misha-z1nchuk/dronebench-ate/README.md

# DroneBench ATE

Automated test equipment for 1S FPV drones. The bench answers one question —
*is this airframe safe to fly, and if not, what should I check next?* — by
measuring the power path while driving the flight controller through a
standardised test sequence.

**Status: in development.** Nothing here is validated against hardware yet.

- [Plan and schematics](dronebench_ate_final_plan.md) (Ukrainian)
- [Progress log](PROGRESS.md) (Ukrainian)

## What it does

Measures battery voltage and current draw through a custom analog front-end,
cross-checked against an independent I2C reference so the bench can state its
own measurement uncertainty rather than assume it. Runs each motor separately
with props removed, compares current profiles, and classifies the result:

```
PASS · REPAIR_MINOR · REPAIR_ELECTRONICS · UNSAFE · UNKNOWN
```

Reports name what was observed, what could cause it, and which test isolates
it — never that a specific part has failed, unless an isolation test proved it.

## Layout

```
firmware/core/       portable logic — no vendor SDK headers, ever
firmware/platform/   host / esp32 / stm32 implementations of platform.h
firmware/app/        wiring for the target build
firmware/tests/      host unit tests for the core
tools/               Python: serial logger, report generator, simulator
test_profiles/       per-airframe limits
docs/                measurement methodology, error budget
```

The core compiles and passes its tests on a desktop compiler with no board
attached. That constraint is what keeps it portable between ESP32 and STM32.

## Build

Host tests, no hardware needed:

```sh
make test
```

Firmware (ESP-IDF v5.5, target ESP32):

```sh
. ~/esp/esp-idf/export.sh
idf.py -C firmware/app/esp32 build flash monitor
```

On macOS and Linux, `install.sh` deliberately does not install CMake and Ninja
— it expects them from the system package manager. If `idf.py` reports
`"cmake" must be available on the PATH`, pull them into the IDF toolchain
instead of installing them system-wide:

```sh
python3 $IDF_PATH/tools/idf_tools.py install cmake ninja
```

## Editor

VS Code with the **clangd** extension. The Microsoft C/C++ extension is
disabled for this workspace in `.vscode/settings.json` — it tries to index the
whole ESP-IDF tree up front and stalls; clangd reads `compile_commands.json`
and indexes lazily.

Two config files make it work: `.clangd` strips four GCC-only flags that clangd
rejects outright, and `compile_flags.txt` covers the portable core, which no
`compile_commands.json` describes. Run `make fw` once before opening the ESP32
sources — the compilation database is generated by the build.

## Hardware

| | |
|---|---|
| MCU | ESP32-WROOM-32 → STM32 NUCLEO-F446RE |
| Current, analog | ACS724 + ADC1, ratiometric VCC correction |
| Current, reference | INA226 + 10 mΩ shunt over I2C |
| Voltage | 10k/10k divider, RC filtered |
| Device under test | BetaFPV Meteor75 Pro, 1S |

Pin map and schematics: [plan §4](dronebench_ate_final_plan.md).

## Safety

Motor current never passes through a breadboard or Dupont wiring. Props are
removed for every test. The full checklist is in the plan — read it before
connecting a battery.
