misha-z1nchuk/dronebench-ate/PROGRESS.md

# DroneBench ATE — журнал прогресу

Робочий трекер. План і схемотехніка — у [dronebench_ate_final_plan.md](dronebench_ate_final_plan.md).

---

## Статус

| | |
|---|---|
| **Поточна фаза** | Фаза 1 — Software |
| **Поточний день** | Фаза 1 завершена. Далі Фаза 1b (MSP spike) або День 11 — монтаж |
| **Дата старту** | 2026-08-05 |
| **Блокери** | немає. Одноразовий `power-on` ресет 22:28 не повторився на повному 10-хвилинному прогоні |
| **Наступний блокер** | немає — усе залізо на місці, Фаза 2 відкрита після Дня 10 |
| **Формат роботи** | див. [Розподіл роботи](#розподіл-роботи) |

**Зараз у роботі:** Дні 1–10 закриті, **Фаза 1 завершена**. Milestone 1 виконаний окрім README в корені. Далі на вибір: Фаза 1b (MSP spike — потрібні лише дрон, батарея і USB) або День 11 (монтаж аналогового тракту). Фазу 1b варто зробити не пізніше Дня 16.

**Легенда:** ⬜ не почато · 🟡 в роботі · ✅ готово · ⏸ відкладено

---

## Як користуватись

1. Починаючи день — міняєш ⬜ на 🟡 у заголовку.
2. Закриваючи — ✅ і ставиш дату.
3. Усі виміряні числа йдуть у [Журнал вимірювань](#журнал-вимірювань), а не в голову.
4. Кожне рішення «купувати / не купувати / робити інакше» — у [Журнал рішень](#журнал-рішень) з причиною.
5. Теорія на день — 30–60 хвилин. Критерій засвоєння: можеш відповісти на питання в кінці блоку **своїми словами, без гуглення**.

---

## Постачання

**Усе на місці.** Вхідний контроль пройдено 2026-08-12, результати в [Журналі вимірювань](#журнал-вимірювань).

### Є
- [x] ESP32-WROOM-32, Meteor75 Pro, батареї **1S LiHV** (4.35 V), MB102
- [x] ACS724 50A — **виконання AB**, підтверджено вимірюванням
- [x] BT2.0 extension ×2, провід 18AWG, резистори 1 Ω 50 W ×2
- [x] Резистори 10 kΩ і 20 kΩ, конденсатори 100 nF, Dupont, термоусадка
- [x] Logic analyzer 8ch/24MHz
- [x] NUCLEO-F446RE
- [x] **Мультиметр** VIRONE dm-1 — після заміни крони справний

### Лишилось перевірити — некритичне, нічого не блокує
- [ ] Розкид 5 резисторів із пачки 10 kΩ — єдине, що цей прилад міряє достовірно
- [ ] Груба перевірка 1 Ω (має показати 1.2–1.8 разом зі щупами, не 10)
- [ ] Logic analyzer + PulseView, зловити UART від ESP32
- [ ] NUCLEO: том `NODE_F446RE` — **чекає кабель Type-C → Mini-USB**

### Рішення відкладені
- [ ] INA226 з шунтом **0.01 Ω** — купувати чи ні, вирішується після Дня 13 за критерієм 3.3.1 плану
- [ ] Тримач автозапобіжника + ножові 15/20 A — безпека, до Дня 15

### Перевірити вдома
- [ ] Паяльник 60 W+, припій, флюс
- [ ] Металева пластина / радіатор під резистори 1 Ω

---

# ФАЗА 1 — Software (Дні 1–10)

Не потребує жодного заліза, крім самої ESP32.

---

### ✅ День 1 — ESP-IDF і repository — 2026-08-06

**Мета:** ESP32 стабільно збирається, шиється і щось каже в UART.

- [x] Встановити ESP-IDF v5.5 + тулчейн для esp32 → `~/esp/esp-idf`
- [x] `.gitignore`, README-заготовка
- [x] Створити структуру каталогів за розділом 6 плану
- [x] Host-збірка і test runner (`make test`)
- [x] Записати модель плати і заповнити pin map (розділ 4.5 плану)
- [x] Каркас застосунку `firmware/app/esp32`, збірка проходить (181 KB)
- [x] Прошито на плату, банер і heartbeat працюють — 2026-08-05
- [x] Розмір флеш підтверджено `esptool flash_id` → 4 MB, виставлено в `sdkconfig.defaults`
- [x] Банер: chip model, revision, cores, features, free heap, reset reason
- [x] Перший commit `de00dff`, запушено на github.com/misha-z1nchuk/dronebench-ate

**Активація середовища у новому терміналі:** `. ~/esp/esp-idf/export.sh`

**Пастка, на яку натрапили:** `install.sh` на macOS навмисно не ставить `cmake` і `ninja` — очікує їх від системного пакетного менеджера. `idf.py` падає з `"cmake" must be available on the PATH`. Витягли їх у тулчейн IDF, не в систему:

```sh
python3 $IDF_PATH/tools/idf_tools.py install cmake ninja
```

Ще одна: `. export.sh` не можна запускати через pipe (`. export.sh | tail`) — pipe створює підоболонку, і змінні середовища не долітають до поточного шелу.

**Done коли:** `idf.py flash monitor` показує банер із версією і причиною ресету; після `Ctrl+T Ctrl+R` причина ресету змінюється.

**Теорія:**
- Що таке toolchain і навіщо cross-compilation. Чим `xtensa-esp32-elf-gcc` відрізняється від системного `gcc`.
- Boot flow ESP32: ROM bootloader → second-stage bootloader → app. Де живе кожен.
- Partition table: що таке `factory`, `nvs`, `phy_init`.
- Reset reasons: power-on, brownout, watchdog, panic. Чому це перше, що треба логувати.

> **Питання:** що відбувається між подачею живлення і викликом `app_main()`?

---

### ✅ День 2 — UART CLI — 2026-08-06

**Мета:** з платою можна розмовляти текстом.

**Ядро — готове, 19 тестів, `make test` = PASS**

- [x] Line buffer з фіксованим розміром, без динамічної пам'яті
- [x] Обробка `\r`, `\n`, `\r\n`, backspace, DEL, недрукованих
- [x] Overflow: рядок довший за буфер не ламає парсер і дає зрозумілу помилку
- [x] Таблиця команд замість ланцюжка `if/else`
- [x] Токенізація на місці, без копіювання
- [x] Реакція на невідому команду, порожній рядок і надлишок аргументів
- [x] Жодного `strcpy`, `strcat`, `sprintf`, `gets`, `malloc`

**Підключення до заліза — готове**

- [x] `cli_uart.c` — драйвер UART0, таска-читач, вихідний адаптер
- [x] Таблиця команд у застосунку: `help`, `version`, `status`
- [x] Перевірено в `idf.py monitor`: команди, помилки, backspace, відновлення після переповнення

**Знайдено під час роботи:**

- Тест не ловив, що після відхиленого рядка буфер не скидався. Наслідок був не «помилка», а **виконання попередньої команди замість нової** — стенд мовчки робив не те, що просили. Додано регресійний тест.
- `tokenize_line` мовчки обрізав до `CLI_ARGS_MAX` замість повідомити про переповнення. Той самий клас проблеми, що й тиха втрата вибірок телеметрії.

**Done коли:** можна вставити в термінал 500 символів сміття — CLI відповідає помилкою і далі працює нормально.

**Теорія:**
- UART: baud rate, старт/стоп-біти, парність, framing error. Чому 115200.
- Ring buffer: навіщо і як реалізується без блокувань.
- Чому `strcpy`/`sprintf` заборонені в embedded і що замість них (`strncpy` теж має пастку — яку?).
- Stack vs heap у мікроконтролері. Чому `malloc` уникають.

> **Питання:** чим `snprintf` безпечніший за `sprintf` і що він повертає, якщо буфер замалий?

---

### ✅ День 3 — Portable core — 2026-08-07

**Мета:** ядро компілюється і тестується на Mac без жодного ESP-IDF.

- [x] `platform.h` — інтерфейс за розділом 6 плану
- [x] Ядро не містить жодного `#include "esp_*"`
- [x] Host-збірка, `make test` — 27 випадків, 82 перевірки
- [x] `check-core` — вартовий межі, падає при вендорному заголовку в `firmware/core/`
- [x] Host-платформа: керований час, підставні покази, захоплений вивід
- [x] ESP32-платформа: час, UART, LED, watchdog. ADC — чесні відмови до Дня 12
- [x] Консольний порт переїхав із `cli_uart.c` у платформу — прихованої залежності за порядком більше немає
- [x] Перевірено на залізі: uptime росте, купа стабільна між викликами

**Знайдено під час роботи:**

- `platform_watchdog_feed` реалізована, але **нічого не годує**: жодна таска не підписана на TWDT, тому `esp_task_wdt_reset()` завжди повертає `ESP_ERR_NOT_FOUND`. Зафіксовано коментарем у коді. **Перевірити на Дні 10.**
- Забутий `#include` дав помилку формату в іншому місці й іншого змісту: без оголошення C припускає, що функція повертає `int`. Перша помилка в списку компілятора майже завжди справжня, решта — наслідки.
- clangd не знаходить базу збірки для файлів поза деревом проєкту ESP-IDF. Розв'язано локальним `.clangd` у `firmware/platform/esp32/`. Той самий трюк знадобиться для STM32.

**Done коли:** `make test` працює на Mac, і в `firmware/core/` немає жодної згадки про ESP-IDF.

**Теорія:**
- Що таке HAL і навіщо шар абстракції. Ціна абстракції.
- Dependency injection у C: вказівники на функції, структури-втабліці.
- Compilation vs linking. Що таке translation unit, `static`, `extern`.
- Чому юніт-тести в embedded зазвичай запускають на хості, а не на залізі.

> **Питання:** як протестувати код, що читає час, не чекаючи реального часу?

---

### ✅ День 4 — Семплер і валідація — 2026-08-21

**Мета:** ядро вміє «вимірювати» без сенсорів і не вірить зіпсованим даним.

- [x] Fake measurement provider за `platform.h` — зроблено на Дні 3
- [x] Монотонні мітки часу `uint64_t`, відхилення немонотонних
- [x] Fault injection: відмова каналу, NaN, Inf, немонотонний час, розриви
- [x] Кожна відмова має власний лічильник — кількість невзятих вибірок є частиною результату
- [x] Опційний референсний канал деградує до `NAN`, а не валить сесію
- [x] 13 тестових випадків, `make test` — 40 випадків / 148 перевірок PASS

**Відкладено, і чому:** профілі `normal` / `motor4_fail` / `sag` / `short` — це генератор реалістичних форм сигналу, і йому поки нема куди подавати дані. Робиться разом із Днем 6 (машина станів), потрібен до Дня 9.

**Хто писав:** `sampler_take` і `sampler_had_trouble` — Claude, після того як я застряг. Решта дня моя. Див. [Розподіл роботи](#розподіл-роботи).

**Ключові рішення в коді:**

- `*out` заповнюється **тільки** при `SAMPLE_OK` — викликач, що отримав відмову, тримає рівно те, що мав до виклику
- Відхилена вибірка **не оновлює** `last_timestamp_us` — інакше один збій перевів би годинник сесії назад і поклав усі наступні
- `isfinite()`, а не перевірка на `NAN` — нескінченність з'являється від ділення на нульовий коефіцієнт калібрування і проходить будь-яку перевірку діапазону
- Порівняння часу через `<=`, не `<` — дві вибірки з однаковою міткою це збій, а не «дуже швидко»

**Done коли:** зіпсовані вибірки відхиляються з лічильником, а не ламають розрахунки. ✅

**Теорія:**
- Чому мітки часу монотонні і чому `uint64_t`. Коли переповниться `uint32_t` у мікросекундах?
- Timer wraparound і правильне віднімання міток часу.
- Float у мікроконтролері: чи є FPU в ESP32 і в STM32F446, ціна `double`.
- NaN, Inf, `isfinite()`. Що станеться з середнім, якщо в вибірці один NaN.

> **Питання:** чому `if (now - last > timeout)` безпечніше за `if (now > last + timeout)`?

---

### ✅ День 5 — Розрахунки метрик — 2026-08-21

**Мета:** з потоку вибірок виходять коректні метрики.

- [x] Потужність, min/max напруги, піковий струм
- [x] Спожиті mAh через інтегрування по часу
- [x] Спожиті Wh
- [x] Середній струм, тривалість сесії
- [x] 9 тестових випадків, `make test` — 49 випадків / 173 перевірки PASS

**Хто писав:** Claude, за розподілом — арифметика не embedded. Ключове рішення про ширину акумулятора розібране нижче.

**Головне з дня — чому акумулятори `double`, а результати `float`**

Годинна сесія на 500 Hz — це 1.8 млн додавань. У `float` це втрачає **+1.5%** на бездоганних вхідних даних:

```
правильно  1000.00 mAh
double     1000.00 mAh   ±0.0000%
float      1014.99 mAh   +1.4994%
```

Причина: точність `float` **відносна**. Коли акумулятор доріс до 3.6e9, крок між сусідніми представними значеннями — 429, а доданок 2000 це лише ~4.6 кроки. Кожне додавання округлюється, округлення зміщені в один бік, і похибка росте **лінійно** з кількістю вибірок.

Тест `charge accumulates across a long session without drifting` перевірений підміною типу — з `float` падає. Тобто це не коментар, а виконуваний захист.

**Embedded-нюанс:** ні Xtensa LX6 в ESP32, ні Cortex-M4F у STM32F446 **не мають FPU подвійної точності**. Уся арифметика `double` — програмна емуляція. Тут це прийнятно: 500 операцій на секунду проти 240 МГц. Але саме тому результати назовні лишаються `float` — вони віддаються один раз, а акумулятори працюють на кожній вибірці.

**Друга пастка — приведення типу в множенні**

```c
acc += sample->current_a * dt_us;          // ❌ множення у float
acc += (double)sample->current_a * dt_us;  // ✅ множення в double
```

Без приведення добуток обчислюється у `float` і лише готовий результат розширюється при додаванні. Тобто акумулятор широкий, а годують його вже округленими числами.

**Знайдено в інфраструктурі:** Makefile не відстежував заголовки. Зміна `.h` не викликала перезбірку, і тест показував `PASS` там, де мав падати. Виправлено через `-MMD -MP` + `-include`. Найгірший клас проблем зі збіркою — та, що не помиляється, а **бреше про успіх**.

**Done коли:** тести на відомих сигналах сходяться з аналітичним результатом. ✅

**Теорія:**
- Чисельне інтегрування: метод прямокутників vs трапецій. Похибка кожного.
- Накопичення похибки при додаванні мільйонів `float`. Чому акумулятор краще тримати в `double`.
- A·µs → mAh: звідки береться 3.6e6.
- Що робити з розривом у потоці вибірок — інтегрувати чи ні.

> **Питання:** чому сума 10 000 однакових `float` не дорівнює `значення × 10000`?

---

### ✅ День 6 — Машина станів сесії — 2026-08-21

**Мета:** сесія тесту має чіткі стани й дозволені переходи.

- [x] Фази `IDLE → PRECHECK → RUNNING → DONE`
- [x] Знахідки `warned` / `failed` / `unsafe` — фіксуються, не скидаються
- [x] Заборонений перехід відхиляється й рахується, а не виконується мовчки
- [x] `session_state_name()` видає лексику плану: IDLE / PRECHECK / RUNNING / WARNING / FAILED / UNSAFE / COMPLETE
- [x] 19 тестових випадків, `make test` — 68 випадків / 255 перевірок PASS

**Дизайн мій, реалізація спільна.**

**Ключове рішення — фази й знахідки окремо**

Початковий список у плані змішував дві незалежні осі:

```
IDLE  PRECHECK  RUNNING  COMPLETE     ← де я в послідовності
WARNING  FAILED                        ← що я знайшов
```

Плоска машина з семи станів дала б **15 переходів**, де `WARNING` дублює майже всі переходи `RUNNING`. І головне — шлях `RUNNING → WARNING → COMPLETE` завершується у `COMPLETE`, і **попередження зникає**: стан його не пам'ятає. Тобто прапорець `had_warning` довелося б завести все одно.

Розділення дає **5 переходів** плюс три незалежні прапорці. Лексика плану лишається як похідне значення — оператор думає станами, код працює фазами.

**Рішення, зашиті в контракт**

| Питання | Відповідь | Чому |
|---|---|---|
| `WARNING → RUNNING`? | ні, фіксується | мета сесії — вердикт, а не поточний стан. Аномалія на 200 мс — це знахідка |
| `stop` під час тесту | завершує з частковими даними, `STOP_OPERATOR` | викидати зібране гірше, ніж чесно позначити неповним |
| `FAILED` vs `UNSAFE` | різні стани | різна дія оператора: від'єднати як завжди vs **негайно висмикнути батарею** |
| Хто завершує сесію | тестова послідовність | плюс тайм-аут → `UNSAFE`, бо незавершений тест це щось не так |
| `start` після `FAILED` | дозволено одразу | `UNSAFE` вимагає явного `reset` |

**Що було не так у першій реалізації**

- `return false` після успішного виконання — у чотирьох функціях. Стан змінився, викликач думає, що ні
- Не перевірялись передумови — шість функцій робили своє, не питаючи, чи можна
- `raise_failure` і `raise_unsafe` ставили прапорець, але не завершували сесію
- `reset` через `session_init` стирав `rejected_requests` — а цей лічильник належить стенду, не сесії, і фіксує розбіжність між оператором і прошивкою

Головне: **написано, що функція робить, і не написано, коли їй не можна.** Сенс машини станів не у виконанні переходів, а у **невиконанні заборонених**.

**Done коли:** тест перебирає всі пари станів і жоден недозволений перехід не проходить. ✅

**Теорія:**
- FSM у C: `switch` vs таблиця переходів. Коли що.
- Інваріанти стану: що має бути істинним у кожному стані.
- Реентерабельність: що буде, якщо `stop` прилетить під час обробки вибірки.

> **Питання:** чим машина станів краща за набір булевих прапорців?

---

### ✅ День 7 — Телеметрія — 2026-08-24

**Мета:** формат даних, який переживе зміну версії й зіпсований канал.

**`make test` = 101 випадок / 467 перевірок PASS. Прошивка збирається без попереджень.**

- [x] Заголовок `TLM,v=2,rate_hz=500,fields=t_us|v|i|i_ref` — версія в першому ж полі
- [x] `S,1000000,4.083,0.420,nan` — 28 байт, позиційний
- [x] `U,n=...,mah=...,sensor=...,rej_time=...,rej_val=...,gaps=...,drop=...` — іменований, порядок не має значення
- [x] Кодувальник **відмовляється** видати обрізаний рядок замість того, щоб віддати неповний
- [x] Парсер відхиляє будь-що до заголовка і будь-яку невідому версію
- [x] Round-trip тести: число → рядок → те саме число
- [x] Лічильники `lines_parsed` / `lines_rejected`

**Хто писав:** Claude — рядкова обробка, не embedded.

**Рішення про пропускну здатність**

```
формат                      байт    @115200    @460800
-------------------------------------------------------
SAMPLE з назвами полів        80       144/с      576/с
S — лише сирі значення        28       411/с     1645/с

потрібно                                          500/с
```

Обрано **обидві зміни**: підвищений baud і короткий рядок. Самого лише скорочення замало — 411 проти 500 не вистачає взагалі, а **консоль ділить той самий UART**.

**Не 921600, а 460800.** На 921600 вивід — суцільне сміття. Місток на цій платі виявився **CH340 (1a86:7523)**, а не CP2102, як припускав план; стелю задає драйвер, а не даташит чіпа. Ідентифіковано через `ioreg -p IOUSB -w0 -l`. На 460800 лишається 1645 рядків/с проти потрібних 500.

**Чому похідні величини все одно передаються**

`power_w` і `used_mah` хост може порахувати сам — але лише з тих вибірок, що долетіли. Прошивка бачить усі. При втратах у каналі хостовий інтеграл занизиться, прошивковий лишиться правильним.

Тому вони йдуть у `U` раз на секунду, з боку прошивки. Розбіжність між двома інтегралами = ціна втрачених вибірок у mAh. Той самий принцип, що в §10.1: два незалежні шляхи до одного числа, різниця між ними — міра довіри.

**Половина тестів — про зіпсовані дані.** Навмисно: щасливий шлях виконується щосекунди роботи, а зламані — рівно тоді, коли вже щось пішло не так.

- `S,1000,4.0` — обрив посеред числа, саме так виглядає переповнення UART. `4.0` при цьому цілком валідне
- порожні рядки — не помилка, інакше лічильник помилок стає безглуздим
- `strtof` перевіряється **за позицією зупинки**, не за повернутим значенням: `strtof("banana")` дає `0.0`, і від справжнього нуля це не відрізнити

**Підключення до заліза — зроблено:**

- [x] UART **460800** через `sdkconfig.defaults`
- [x] `idf.py monitor` тримає швидкість (успадковує `ESP_CONSOLE_UART_BAUDRATE`)
- [x] Таска телеметрії: `sampler_take` → `metrics_add` → `telemetry_encode_sample` → `platform_uart_write`
- [x] `U` раз на секунду
- [x] Лічильник `drop` — періоди, які не встигли
- [x] Команди `start` / `stop` через машину станів Дня 6
- [x] `status` показує стан сесії, одним записом у порт

**Перевірка проти аналітичної моделі.** Числа з плати звірені не «на око», а порахованим інтегралом із констант симулятора:

| | плата | розрахунок |
|---|---|---|
| `imax` | 1.980 | `IDLE_A + MOTOR_A` = 0.38 + 1.60 |
| `vmin` | 4.081 | `4.20 − 1.98 × 0.060` |
| `mah` @ n=1000 | 0.621 | 2.236 А·с / 3.6 |
| `wh` @ n=1000 | 0.0025 | 9.169 Вт·с / 3600 |

Збіг тримається до четвертого знака **тільки якщо рахувати 999 інтервалів, а не 1000** — тобто дані підтверджують і правило «перша вибірка заряду не додає» (`metrics.h:11–13`). При 1000 вийшло б 0.6222, і розбіжність 0.2% легко списалася б на округлення.

**Три пастки, кожна з яких мовчала б:**

1. `pdMS_TO_TICKS(2)` при тіку 100 Гц = **0** — цілочисельне ділення. `xTaskDelayUntil` це відхилив і плата пішла в цикл перезавантажень. Виправлено `CONFIG_FREERTOS_HZ=1000` **плюс `_Static_assert`**, який ловить це на компіляції. Перевірено підстановкою: `SAMPLE_RATE_HZ 2000` → збірка падає.
2. `cmd_status` робив **п'ять** `cli_write` підряд. `uart_write_bytes` атомарний у межах одного виклику, тож під час сесії у відповідь вклинювався рядок вибірки. Переписано на один `snprintf` + один запис.
3. Заголовок `TLM,v=1` у логі виказав, що прошивка не оновилась — рівно та причина, для якої версія стоїть першим полем.

**Теорія:**
- Дизайн протоколу: текстовий vs бінарний, коли який.
- Версіонування. Чому версія має бути в першому ж полі.
- Framing: як приймач розуміє, де початок повідомлення.
- CRC: навіщо, чим відрізняється від checksum.

> **Питання:** що станеться з парсером, якщо UART загубить один байт посеред рядка, і як зробити, щоб він відновився?

---

### ✅ День 8 — Python logger — 2026-08-24

**Мета:** дані з плати лягають на диск без втрат.

- [x] pyserial — через `make venv` (macOS має PEP 668 і забороняє системний `pip install`)
- [x] Читання порту, коректна робота з частковими рядками
- [x] Перевірка версії протоколу з заголовка
- [x] Автоперепідключення при відвалі USB
- [x] Запис CSV у каталог сесії з міткою часу
- [x] Лог помилок парсингу окремо, з номером рядка
- [x] `--simulate` / `--start` / `--for` — логер сам веде сесію
- [x] **Фізична перевірка** — USB висмикнуто посеред сесії

`tools/serial_logger/`: `protocol.py` (формат, без залежностей), `logger.py`, `test_protocol.py` — 31 тест, `make pytest`. Guard-и перевірені підстановкою: без `isfinite` падає 2 тести, зі зламаним збирачем рядків — 4.

**Наскрізна перевірка проти моделі.** 8-секундний прогін `simulate normal`, 4027 вибірок, 8 підсумків, 0 помилок. Кожен рядок `summaries.csv` звірений із чисельним інтегралом по константах симулятора:

| n | mah плата | mah модель |
|---|---|---|
| 500 | 0.105 | 0.1053 |
| 1000 | 0.622 | 0.6216 |
| 2000 | 1.466 | 1.4656 |
| 4000 | 3.410 | 3.4096 |

Розбіжність у всіх восьми точках дорівнює **рівно** різниці між моделлю та моделлю, округленою до трьох знаків. Тобто число на платі — це модель із точністю float, а вся дельта є форматом дроту.

Усі **4026** інтервалів між вибірками — рівно 2000 мкс. Частота 500.00 Гц. Джитер, записаний у борги Дня 10, на симуляції не проявляється; справжня перевірка — під навантаженням Фази 2.

**Спростована гіпотеза:** я вирішив, що відкриття порту скидає плату через DTR/RTS, і записав це в код як факт. Перша мітка часу показала 791 с аптайму — плата пережила відкриття. Причина порожнього першого логу була простіша: сесія не була запущена. Коментар виправлено; затримка на завантаження лишена, бо на іншій платі скид цілком можливий.

**Перевірка розриву — зроблена, не змодельована.** Кабель висмикнуто на 15-й секунді запису:

- `stream_001` містить **усі 7349 вибірок** до моменту розриву, 14.696 с
- `errors.log` **порожній** — обірваний хвіст збирач не віддав, бо тримає рядок до `\n`
- логер перепідключався раз на секунду, поки вузла `/dev/cu.*` не існувало, і після повернення **сам переслав `simulate` і `start`** — цей блок стоїть усередині циклу перепідключення
- `stream_002` почався з `t_us = 2844341` проти `1033664334` у першому. Висмикування знімає живлення, плата перезавантажується, її годинник іде з нуля. В одному файлі це був би стрибок мітки часу **назад на 17 хвилин**, а віднімання двох міток у беззнаковій арифметиці перетворило б від'ємний інтервал на величезний додатний. Розбиття по заголовку саме для цього

**Джитер на довшій вибірці.** 14.7 с дали `{2000: 6762, 2002: 293, 1998: 293}` — ±2 мкс на 8% інтервалів, рівно порівну в обидва боки, тобто биття фази між тіком FreeRTOS і `esp_timer`, не дрейф. Середнє точно 2000. У 8-секундному прогоні цього не було видно взагалі.

**Done коли:** ✅ висмикування USB посеред сесії не втрачає вже записані дані і логер сам відновлюється.

**Теорія:**
- Serial port на хості: буферизація, `timeout`, чому читання по рядках небезпечне.
- Чим `flush()` відрізняється від `fsync()`.
- CSV як формат: коли ламається, навіщо quoting.

> **Питання:** чому не можна просто робити `readline()` і вважати, що прийшов цілий рядок?

---

### ✅ День 9 — Графіки і звіт — 2026-08-24

**Мета:** з CSV виходить читабельний звіт.

- [x] Графіки voltage / current / power по часу, спільна вісь часу
- [x] Summary: min V, max I (p99), avg I, mAh, Wh, тривалість
- [x] Pass/Fail за профілем із розділу 10 плану
- [x] Звіт у форматі розділу 11 плану
- [x] Прогін на `motor4_fail` → звіт називає проблему
- [x] Позначка на графіку, де саме спрацювало правило

`tools/report_generator/`: `analysis.py` (правила, лише стандартна бібліотека), `report.py`, `plots.py`, `generate.py`. 31 тест. Пороги — у `test_profiles/meteor75pro.toml`, не в коді.

**Чотири вердикти, і INCONCLUSIVE вище за PASS.** Прогін, який не вдалося оцінити, — це не прогін, що пройшов. Повертається коли: поріг у профілі досі `tbd`; прошивка не прийняла жодної вибірки (тоді всі числа нулі, бо нічого не міряли, а не бо нічого не було); відповів лише один струмовий канал, тож §10.1 не обчислити.

**Звіт читає `errors.log` логера.** Лінія, яка побила частину рядків до невпізнання, побила й інші — у значення, які **досі парсяться**: втрачена крапка перетворює `4.081` на `4081`. Такі рядки вже лежать у CSV у вигляді вимірювань. Без цієї перевірки звіт звинуватив калібрування ADC у тому, що насправді зробив розхитаний USB-роз'єм.

**Три статистичні рішення, кожне з тестом:**

| вибір | чому |
|---|---|
| медіана, не середнє | дев'ять побитих семплів із тисячі зсувають середнє на 46% і засуджують справний мотор. Медіану не зсувають. Є тест, який падає при підміні на середнє |
| p99, не `max` | максимум — це один семпл, тож його визначає один збій ADC. І він може лише зростати, тобто метрика тим гірша, чим довший тест |
| рахувати сегменти, не лише міряти | мотор, що бере забагато, заявляє про себе сам. Мотор, що не бере нічого, виглядає як тиха ділянка запису |

Місце відсутнього мотора виводиться з ритму тих, що працювали, і малюється на графіку **як очікуване, не як виміряне** — інакше на графіку з'явився б вимір, якого ніхто не робив.

**`data/baselines/motor4_fail/`** — синтетичний запис із наперед відомим дефектом. Фікстура з відомою правильною відповіддю, для якої не потрібні ані плата, ані зламаний дрон.

**Done коли:** ✅ звіт по `motor4_fail` називає проблему, ймовірні причини і наступний тест — без ручного втручання.

**Теорія:**
- Медіана vs середнє. Чому для порівняння моторів беруть медіану.
- Стандартне відхилення, викиди, чому один поганий семпл не має валити тест.
- Percentile і чому peak current краще брати як p99, а не як max.

> **Питання:** чому `max()` — погана метрика для пікового струму на реальних даних?

---

### ✅ День 10 — FreeRTOS cleanup — 2026-08-24

**Мета:** три таски, одна черга, нуль гонок. Вийшло **чотири таски й дві черги** — CLI-таска існувала з дня 2, і план її не рахував.

- [x] `measurement_task` — тільки бере вибірки, пріоритет 7
- [x] `processing_task` — метрики й кодування, пріоритет 5
- [x] `output_task` — єдиний писар у порт, пріоритет 6
- [x] Черга вибірок (16 × 24 Б) і черга виводу (8 × 194 Б)
- [x] Жодних глобальних змінних, що пишуться з двох тасок
- [x] Запас стеку кожної таски виміряно
- [x] Переповнення черг — з лічильниками, `missed` / `qdrop` / `odrop` у `status`
- [x] Task watchdog — усі три вічні таски підписані
- [x] **Доведено, що сторож спрацьовує** — див. нижче

**Межа проведена не за «що робить», а за «на чому спить».** Одна таска може чекати рівно на одній речі, і саме це визначає, де розріз:

| таска | спить на | може блокуватись |
|---|---|---|
| measure | власному таймері | **ніколи** |
| output | черзі виводу | так, скільки завгодно |
| process | черзі вибірок | так |
| cli | UART RX | так |

**Два різні відповіді на «черга нижче повна»**, і різні вони тому, що втрати різні:

- *measurement* — викинути й порахувати. Чекати місця означало б пропустити наступний період, тобто ту саму втрату іншим шляхом. Викинута вибірка коштує точки на графіку; **запізніла зсуває часову шкалу**, з якої будуються всі подальші числа.
- *processing* — вибірка вже в метриках, тож втрачається **рядок на дроті, а не число**. Прошивковий mAh лишається правильним, діра з'являється лише у хоста. Це і є §10.1 у мініатюрі.

**Скидання стану через лічильник поколінь.** До дня 10 CLI-таска викликала `sampler_init` і `metrics_init` напряму, лізучи в структури, якими в цю мить користувалась таска на 500 Гц. З одним власником це виживало під замком; з двома — ні. Тепер `telemetry_session_start` лише збільшує `s_generation`, а кожна таска сама чистить те, чим володіє, у зручний собі момент.

**Сторож забороняє вічний сон.** `xQueueReceive(..., portMAX_DELAY)` був би безкоштовний і правильний — рівно до першої тихої секунди, коли таска не встигла б доповісти, що жива, і плата перезавантажилась би за те, що їй нічого сказати. Звідси таймаути 1000 мс скрізь: сторож має 5 с.

**Сторож за замовчуванням тільки скаржився.** `CONFIG_ESP_TASK_WDT_PANIC` не був встановлений: TWDT друкував попередження і давав платі працювати далі. Для стенда, який крутитиме мотори, це неправильний бік компромісу — зависла таска з мотором у русі це момент привести систему у **відомий** стан, а не подати рапорт у консоль, якої ніхто не читає. Поставлено `=y`.

**Доказ спрацювання.** У `output_task` тимчасово вставлено `vTaskDelay(portMAX_DELAY)` — таска спить вічно, тактів не витрачає. Саме так, а не `while(1){}`: тугий цикл забрав би ядро, спрацював би **idle**-сторож, який працював і до Дня 10, і доказ був би не про те.

```
task_wdt: Task watchdog got triggered ... did not reset the watchdog in time:
task_wdt:  - output (CPU 0/1)          ← називає винну таску
task_wdt: Tasks currently running:
task_wdt: CPU 0: IDLE0                 ← обидва ядра простоювали
task_wdt: CPU 1: IDLE1
Rebooting
 reset reason task watchdog             ← причина пережила ресет
```

`IDLE0`/`IDLE1` — і є доказ: процесор був вільний, idle-таски годувались, спіймала винятково підписка. Рівно та форма відмови, що в Дні 7, коли `telemetry_session_start` пропускала `xSemaphoreGive`: таска мертва, процесор вільний, ніхто не помічає. Цикл повторився тричі за 18 с — по одному на 5-секундний таймаут. Після перевірки рядок прибрано, поведінка підтверджена штатною.

**Погодували через `platform_watchdog_feed`.** Борг дня 7 закрито не видаленням, а використанням: гачок був оголошений, реалізований на обох платформах, покритий тестами — і не викликався ніде. Тепер його викликають усі три таски. Підписка (`esp_task_wdt_add`) навмисно **не** абстрагована: вона властивість таски, а таски — платформенний код.

**Борг, принесений із Дня 7:**

- [x] `platform_watchdog_feed` більше не годує ніщо — таски підписані, гачок викликається
- [x] `s_lock` один на все — після розділення `s_sampler` належить measurement, `s_metrics` — processing, замок лишився тільки на `s_session`
- [x] `TASK_STACK` вгадано — виміряно, числа в журналі
- [ ] `xTaskDelayUntil` замінити на пробудження від апаратного таймера. **Понижено в пріоритеті:** заміри показали 500.00 Гц і ±2 мкс на 8% інтервалів, тобто запас є. Повернутись, коли аналоговий тракт додасть роботи у вимірювальний шлях (День 12)

**Done коли:** система працює 10 хвилин без втрат вибірок, запас стеку кожної таски відомий і записаний.

**Десятихвилинний прогін — ✅ пройдено з другої спроби.**

```
300028 вибірок за 600.054 с   →  500.0 Гц
600 підсумків                 →  рівно 1/с
0 помилок парсингу
n=300000, sensor=0, rej_time=0, rej_val=0, gaps=0, drop=0
```

**Усі 300 027 інтервалів — рівно 2000 мкс.** Ані одного відхилення. До розділення тасок прогін на 14.7 с давав ±2 мкс на 8% інтервалів; найімовірніша причина покращення — сам розділ: у вимірювальному шляху лишились `sampler_take` і `xQueueSend`, а метрики з `snprintf` поїхали в іншу таску, тож робота під таймером стала короткою і сталою за часом.

Перша спроба обірвалась на 92-й секунді з `reset reason power-on` — плата втратила живлення. Не повторилось; вважаю одноразовим, але варто пам'ятати, якщо повториться під час калібрування.

**Теорія:**
- Таска vs потік ОС. Пріоритети, витіснення, `vTaskDelay` vs `vTaskDelayUntil`.
- Черга vs семафор vs м'ютекс — що для чого.
- Priority inversion і priority inheritance.
- `...FromISR` API: чому окремі функції для переривань.
- Як рахується розмір стеку таски і що таке stack overflow hook.
- Task watchdog vs hardware watchdog.

> **Питання:** дві таски пишуть у одну змінну `float`. Що конкретно може піти не так на 32-бітному МК?

---

## 🏁 Milestone 1
- [x] Повний тестовий прогін на симуляції, без жодного заліза
- [x] `make test` зелений — 467 перевірок / 101 кейс, плюс `make pytest` 62 тести
- [x] Звіт по `motor4_fail` генерується автоматично — `make report SESSION=data/baselines/motor4_fail`
- [ ] README у корені описує, як це відтворити

---

# ФАЗА 1b — MSP spike (паралельно з Днями 8–10)

Потрібні лише дрон, батарея і USB. **Пропелери зняті.**
Це найризикованіша частина проєкту — перевіряємо її до того, як вкладено час у залізо.

### ⬜ Крок 1 — Читання
- [ ] Підключитись до FC по MSP через USB
- [ ] `MSP_API_VERSION`, `MSP_FC_VARIANT`, `MSP_FC_VERSION`, `MSP_BOARD_INFO`
- [ ] Статус сенсорів, arming flags
- [ ] Зберегти `diff all` з Betaflight у репозиторій

### ⬜ Крок 2 — Motor override
- [ ] `MSP_SET_MOTOR` **без батареї** — чи приймає FC команду взагалі
- [ ] З батареєю, пропелери зняті, один мотор, мінімальний throttle

### ⬜ Крок 3 — Головне питання
- [ ] Чи є timeout на motor override і який він
- [ ] З якою періодичністю треба повторювати команду
- [ ] Чи вдається утримати сталий throttle 5 секунд
- [ ] Що відбувається при обриві USB під час override

**Done коли:** записано в [Журнал рішень](#журнал-рішень), чи можливий керований відтворюваний motor test. Якщо ні — Дні 19–21 перепроєктовуються.

**Теорія:**
- Структура MSP-фрейму: preamble, direction, size, command, payload, checksum.
- Request/response протоколи: таймаути, ретраї, ідемпотентність.
- Чому в протоколах керування моторами обов'язковий watchdog на стороні виконавця.

> **Питання:** чому команда «крутити мотор» має протухати, а не діяти вічно?

---

# ФАЗА 2 — Analog front-end (Дні 11–16)

⚠️ Потрібен мультиметр. Не починати без нього.

### ⬜ День 11 — Монтаж
- [ ] Дільник напруги 10k/10k на MB102
- [ ] Дільник ACS724 OUT 10k/20k
- [ ] Дільник ACS724 VCC 10k/20k
- [ ] RC-фільтри 100 nF на всіх трьох
- [ ] Star ground
- [ ] Continuity-перевірка всієї схеми **до** подачі живлення
- [ ] Перевірка напруг мультиметром **без дрона і без MCU**
- [ ] Тільки після цього підключити ESP32

**Done коли:** усі три вузли ADC показують напругу в межах 0–2.4 V при найгіршому вхідному сценарії.

**Теорія:** дільник напруги, еквівалент Тевеніна, вхідний імпеданс ADC і чому джерело має бути «жорстким», RC-фільтр і частота зрізу.

> **Питання:** чому дільник з резисторами 1 MΩ зіпсує вимірювання на ADC?

### ⬜ День 12 — ADC напруги
- [ ] Конфігурація ADC1, атенюація 12 dB
- [ ] Multisampling 64–256 вибірок
- [ ] Калібрування через eFuse Vref
- [ ] Порівняння з мультиметром у 5 точках: 3.2 / 3.5 / 3.8 / 4.1 / 4.2 V
- [ ] Обчислити реальний коефіцієнт дільника
- [ ] **Записати шум ADC у [Журнал вимірювань](#журнал-вимірювань)** — це вхідні дані для рішення по INA226

**Теорія:** SAR ADC, роздільність vs точність, INL/DNL, шум квантування, oversampling (чому 4× дає +1 біт), опорна напруга.

> **Питання:** ADC 12 біт. Чи означає це 12 біт точності?

### ⬜ День 13 — ACS724 zero + ratiometric
- [ ] Визначити виконання модуля: AB чи AU (розділ 4.2 плану)
- [ ] Канал моніторингу VCC
- [ ] Offset при нульовому струмі
- [ ] Шум за 10 секунд, RMS і peak-to-peak
- [ ] Порівняти moving average vs IIR
- [ ] **РІШЕННЯ: чи потрібен INA226** за критерієм 3.3.1 плану

**Теорія:** ефект Холла, ratiometric-сенсори, offset/gain error, температурний дрейф, теорема Котельникова і аліасинг, moving average vs IIR.

> **Питання:** чому одноразове калібрування нуля не рятує ratiometric-сенсор?

### ⬜ День 14 — INA226 *(якщо купувався)*
- [ ] I²C bring-up, сканування шини
- [ ] Configuration і Calibration регістри під шунт 0.01 Ω
- [ ] Читання shunt / bus / current / power
- [ ] Порівняти bus voltage з власним каналом напруги

**Теорія:** I²C — start/stop, ACK, адресація, clock stretching; регістрові карти; Kelvin (4-провідне) підключення шунта.

> **Питання:** навіщо шунт підключають чотирма провідниками, а не двома?

### ⬜ День 15 — Резистивне навантаження
- [ ] Виміряти реальний опір резистора 1 Ω мультиметром
- [ ] Короткий тест 10–20 с
- [ ] Очікуваний струм за законом Ома
- [ ] Порівняти: розрахунок vs ACS724 vs INA226
- [ ] Виміряти сумарний опір силового тракту
- [ ] Спостерігати нагрів, не торкатись

**Теорія:** закон Ома, розсіювана потужність, теплове derating, опір проводу і AWG, перехідний опір роз'ємів.

> **Питання:** чому виміряний струм менший за `4.2 / 1.0`?

### ⬜ День 16 — Error budget
- [ ] Два резистори паралельно, якщо безпечно
- [ ] Voltage sag під навантаженням
- [ ] 5 повторних прогонів, оцінити відтворюваність
- [ ] **Заповнити таблицю error budget у розділі 10.1 плану реальними числами**

**Теорія:** невизначеність вимірювання, accuracy vs precision, поширення похибки, відтворюваність vs повторюваність.

> **Питання:** прилад показує 1.234 A. Скільки з цих цифр мають сенс?

## 🏁 Milestone 2
- [ ] Напруга і струм валідовані, похибка відома і записана
- [ ] Зрозуміло, який канал може ухвалювати рішення про мотори

---

# ФАЗА 3 — Дрон (Дні 17–21)

### ⬜ День 17 — Precheck
- [ ] **Пропелери зняті**
- [ ] Backup конфігу Betaflight у репозиторій
- [ ] Перевірка полярності BT2.0
- [ ] Continuity-перевірка harness
- [ ] Перше подання живлення через стенд
- [ ] Idle current baseline на 3 батареях

**Теорія:** хімія LiPo, C-rating, внутрішній опір, voltage sag, inrush current при підключенні.

### ⬜ День 18 — MSP у runner + синхронізація часу
- [ ] Перенести результати Фази 1b у Python runner
- [ ] ESP32 шле монотонний `time_us`
- [ ] Ping-echo для оцінки offset і skew
- [ ] Перевірити, що подія «мотор стартував» лягає на пік струму

**Теорія:** clock offset vs skew, оцінка затримки за round-trip, чому два USB-потоки не синхронні.

### ⬜ День 19 — Motor test
- [ ] Мотори 1–4 окремо, однаковий профіль
- [ ] Профіль струму по кожному
- [ ] Медіана і відхилення

**Теорія:** brushed vs BLDC, ESC, PWM і DShot, залежність струму від навантаження.

### ⬜ День 20 — Diagnostic rules
- [ ] Мотор не стартує
- [ ] Підвищений струм мотора
- [ ] Battery sag
- [ ] FC reboot під час тесту
- [ ] Sensor timeout

**Теорія:** пороги і гістерезис, false positive vs false negative, ціна кожної помилки в діагностиці.

### ⬜ День 21 — Класифікація
- [ ] `PASS` / `REPAIR_MINOR` / `REPAIR_ELECTRONICS` / `UNSAFE` / `UNKNOWN`
- [ ] Формат Observed / Likely causes / Recommended next test
- [ ] Реальний звіт по Meteor75 Pro

## 🏁 Milestone 3 — мінімально достатній результат
- [ ] Стенд працює на реальному дроні
- [ ] Є один реальний звіт із даними
- [ ] README з фото, прикладом звіту і таблицею error budget
- [ ] Чесний розділ про обмеження

**Це точка, після якої проєкт уже можна показувати.** Усе далі — підвищення цінності, а не умова.

---

# ФАЗА 4 — STM32 (окремий блок, ~8–10 днів)

- [ ] NUCLEO bring-up: CubeIDE/CMake, UART, ST-LINK, breakpoints, reset reason
- [ ] ADC + timer trigger + DMA circular buffer
- [ ] Той самий portable core, той самий Python logger
- [ ] Watchdog
- [ ] Порівняння результатів ESP32 vs STM32 на однаковому навантаженні

**Теорія:** DMA і чому він не безкоштовний, cache coherency, timer-triggered conversion, register-level vs HAL, SWD і як працює апаратна точка зупину.

---

# ФАЗА 5 — CI і демо

- [ ] Host unit tests у CI
- [ ] Статичний аналіз
- [ ] Збірка ESP32 і STM32 в CI, артефакти
- [ ] Відео прогону 60 секунд
- [ ] Розділ «що зробив би інакше»

---

# Розподіл роботи

Обрано 2026-08-06: каркас і тести — Claude, логіка — Misha. Уточнено 2026-08-21 за критерієм «про що спитають на співбесіді».

| Пишу я (Misha) | Чому |
|---|---|
| ADC на ESP32, Дні 12–13 | Конфігурація ADC1, атенюація, multisampling, eFuse-калібрування, аналіз похибки |
| Драйвер INA226, День 14 | Регістрова карта, calibration register, I²C |
| FreeRTOS і watchdog, День 10 | Пріоритети, черги, запас стеку, підписка на TWDT |
| STM32 ADC + timer + DMA, День 22 | Головне в проєкті. Різниця між «користувався HAL» і «розумію периферію» |
| Bring-up NUCLEO, День 21 | Clock tree, SWD, регістри в дебагері |
| Акумулятор mAh у `double`, День 5 | Похибка накопичення `float` — пряме питання на співбесіді |

| Може писати Claude | Чому |
|---|---|
| Метрики, День 5 | Арифметика, не embedded |
| Python-логер і звіти, Дні 8–9 | Не embedded |
| Каркаси, тести, специфікації | Формат від початку |

**Разом:** машина станів (День 6) і протокол (День 7) — дизайн мій, механічна частина спільна.

**Винятки, що вже сталися:**

- `sampler_take` і `sampler_had_trouble` — Claude, 2026-08-21, після того як я застряг. Лишено свідомо; логіка валідації не є embedded-специфічною. `cli.c` написаний мною повністю.
- День 7, 2026-08-24. Моє: `telemetry_session_start`, `telemetry_session_stop`, `telemetry_state_name`, перший підхід до `send_summary` і до тіла циклу. Claude: `run_one_period`, фінальний `send_summary`, обв'язка `main.c` (`cmd_start` / `cmd_stop` / `cmd_status`), ревізія протоколу до v2 і тести до неї.

  Причина зафіксована окремо: тіло циклу я почав правильно **за послідовністю кроків**, але помилився в керуванні потоком — `continue` замість `return`, який пропускав `xTaskDelayUntil`. Це рівно тема Дня 10, і там я пишу все сам.

---

# Журнал вимірювань

Заповнюється по ходу. Порожні клітинки — ще не міряно.

| Параметр | Значення | Дата | Як міряно |
|---|---|---|---|
| Модель чипа | ESP32-D0WD rev v1.0, dual core, 40 MHz crystal | 2026-08-05 | `esptool flash_id` |
| Запас стеку `measure` | використано **656** Б із 3072 | 2026-08-24 | `uxTaskGetStackHighWaterMark`, команда `tasks` |
| Запас стеку `process` | використано **2044** Б із 4096 | 2026-08-24 | те саме |
| Запас стеку `output` | використано **808** Б із 2048 | 2026-08-24 | те саме |
| Запас стеку `cli` | використано **1768** Б із 3072 | 2026-08-24 | те саме, з усіма обробниками |
| Пік черги виводу | **1** із 8 слотів | 2026-08-24 | `ohw` у `status`, міряно з боку читача |
| Частота вибірки | **500.0 Гц**, 10000 вибірок за 20 с | 2026-08-24 | підрахунок рядків `S,` у логері |
| Джитер періоду | 2000 мкс на 92%, ±2 мкс на 8% | 2026-08-24 | різниці міток часу, прогін 14.7 с |
| Втрати на 500 Гц | `missed=0 qdrop=0 odrop=0` | 2026-08-24 | лічильники в `status` після 20 с |
| **Прогін 10 хвилин** | 300028 вибірок, 600.054 с, **500.0 Гц**, 0 втрат | 2026-08-24 | `make log ARGS="--simulate normal --start --for 600"` |
| **Джитер, 10 хвилин** | **усі 300027 інтервалів = 2000 мкс**, без відхилень | 2026-08-24 | різниці міток часу з CSV |

**Про одиниці стека:** у ESP-IDF `StackType_t` це `uint8_t`, тож і розмір стека в `xTaskCreate`, і `uxTaskGetStackHighWaterMark` рахуються **в байтах**. На STM32 з ванільним FreeRTOS це `uint32_t` — ті самі числа означатимуть учетверо більше. Пастка для Днів 21–22.
| Розмір флеш | 4 MB (mfr 5e, dev 4016) | 2026-08-05 | `esptool flash_id`, виставлено в `sdkconfig.defaults` |
| MAC / Device ID | `b4:e6:2d:db:63:1d` | 2026-08-05 | ідентифікатор стенда у звітах |
| **Схема калібрування ADC** | **VRef у eFuse — є** | 2026-08-05 | `esptool flash_id` → Features. Line fitting з eFuse Vref доступний, День 12 розблоковано |
| Резистор 10 kΩ | 9.79 kΩ | 2026-08-12 | DT-830 після заміни крони. Похибка приладу ±0.8% — перевірити допуск 1% ним неможливо |
| Резистор 20 kΩ | 19.73 kΩ | 2026-08-12 | те саме |
| Розкид у пачці 10 kΩ | | | 5 шт підряд — єдине, що цей прилад міряє достовірно |
| Тип батарей | **LiHV**, повний заряд 4.35 V | 2026-08-12 | 4.32 V мультиметром, 4.31 V зарядкою — два незалежні джерела зійшлись |
| Мультиметр | VIRONE dm-1, клас DT-830, 3½ розряди, є діапазон `2000m` | 2026-08-12 | Роздільність 1 mV на 2 V → error budget §10.1 досяжний, якщо міряти на вузлі дільника |
| ESP32 `VIN` (живлення ACS724) | 4.87 V | 2026-08-12 | падіння на діоді Шотткі 0.13 V від USB |
| ESP32 `3V3` | 3.37 V | 2026-08-12 | AMS1117, +2% — на точність ADC не впливає, опора внутрішня ~1.1 V |
| **Виконання ACS724** | **AB, двонаправлений** | 2026-08-12 | VCC 4.81 V → OUT 2.40 V = рівно VCC/2. Формула в §4.2 не змінюється |
| Зсув нуля ACS724 | −5 mV ≈ −0.125 A | 2026-08-12 | ідеал 2.405 V, факт 2.400. Орієнтир для калібрування на Дні 13 |
| Просідання на Dupont до ACS724 | 60 mV (4.87 на ESP32 → 4.81 на модулі) | 2026-08-12 | підтверджує, що канал моніторингу VCC треба брати з модуля, а не з плати |
| Реальний коефіцієнт дільника напруги | | | 5 точок проти мультиметра |
| Шум ADC, RMS | | | 1000 вибірок, нульовий вхід |
| Шум ADC після multisampling ×64 | | | |
| **Роздільність струму ACS724** | | | ← критерій для рішення по INA226 |
| Роздільність струму INA226 | | | |
| Опір резистора 1 Ω (реальний) | | | мультиметр |
| Сумарний опір силового тракту | | | |
| Idle current Meteor75 Pro | | | 3 батареї |
| Startup current peak | | | |
| Запас стеку measurement_task | | | high water mark |
| Запас стеку processing_task | | | |
| Запас стеку communication_task | | | |

---

# Журнал рішень

| Дата | Рішення | Причина |
|---|---|---|
| 2026-08-05 | Дільник напруги 10k/10k замість 10k/20k | 2.90 V виходило за лінійну зону ADC ESP32 |
| 2026-08-05 | Додано ratiometric-канал моніторингу VCC для ACS724 | Нуль ACS724 = VCC/2, USB 5 V гуляє 4.7–5.2 V → ±3 A дрейфу |
| 2026-08-05 | MSP-спайк перенесено з Дня 17 на Дні 8–10 | Не потребує заліза, а це найризикованіша частина плану |
| 2026-08-05 | INA226 не купується наперед | Рішення після вимірювання шуму на Дні 13, критерій — роздільність краще 100 mA |
| 2026-08-05 | Якщо INA226 — то лише версія з шунтом 0.01 Ω | 0.1 Ω дає максимум 0.82 A і 10 W розсіювання при КЗ |
| 2026-08-05 | `battery_max_v` = 4.20 V | Наявні батареї — звичайний LiPo, не LiHV |
| 2026-08-24 | `CONFIG_ESP_TASK_WDT_PANIC=y` | За замовчуванням сторож лише друкує попередження і не скидає плату. Для стенда з моторами зависла таска, яка продовжує «працювати», — гірше за перезавантаження |
| 2026-08-24 | Розриви 18:37–18:50 спричинив **не кабель**, а другий процес на порту | Логер, запущений о 18:30, чотири години стукався в той самий порт. `pyserial` прямо це й писав — «multiple access on port» — і я прочитав повз. Заміна кабеля «полагодила» випадково: вузол став `-10`, і старий процес перестав заважати. Урок: повідомлення про помилку варто дочитувати до кінця, перш ніж будувати гіпотезу з хронології |
| 2026-08-24 | Чотири таски, не три як у плані | CLI-таска існувала з Дня 2 і планом не рахувалась. Межа проводиться за «на чому таска спить», а спати можна лише на одному — читати UART і розгрібати чергу виводу одна таска не може |
| 2026-08-24 | Скидання стану сесії через лічильник поколінь | CLI-таска викликала `sampler_init`/`metrics_init` у структури, якими користувалась таска на 500 Гц. З двома власниками це стало невиправданим. Тепер кожна таска чистить лише своє |
| 2026-08-24 | Черга виводу **не** робить багатозаписну відповідь атомарною | Я стверджував протилежне в `output.h`, і це було неправдою: атомарний один виклик, як і в `uart_write_bytes`. Реальний виграш — відправник ніколи не блокується. Правило Дня 7 («збирай відповідь і пиши одним викликом») лишається обов'язковим, `cli_print_help` виправлено |
| 2026-08-24 | Зайнятість черги виводу міряється з боку читача | Перша спроба міряла після `xQueueSend` і завжди давала нуль: output має вищий пріоритет за відправників і спорожняє чергу до того, як відправник відновиться |
| 2026-08-24 | Профілі тестів — TOML, а не YAML як у §10 плану | `tomllib` у стандартній бібліотеці з Python 3.11. Ті самі п'ятнадцять рядків змісту, мінус залежність на кожній машині, що читає звіт. Ключі не змінені |
| 2026-08-24 | INCONCLUSIVE — окремий вердикт, вищий за PASS | Поріг без baseline не може нічого завалити, тож зелений звіт по такому порогу нічого не означає. Те саме для сесії без жодної прийнятої вибірки |
| 2026-08-24 | Генератор звітів читає `errors.log` логера | Побита лінія дає не лише сміття, а й значення, які парсяться: `4.081` без крапки — це `4081`. Такі рядки вже в CSV. Без цієї перевірки звіт звинуватив калібрування ADC у розхитаному роз'ємі |
| 2026-08-24 | Скид плати: відкриття порту — ні, висмикування — так | Гіпотеза про DTR/RTS спростована: 791 с аптайму пережили відкриття. Висмикування знімає живлення, і годинник іде з нуля — підтверджено вимірюванням (1033664334 → 2844341 мкс) |
| 2026-08-24 | Логер сам веде сесію (`--simulate` / `--start` / `--for`) | Порт тримає один процес. Або монітор, або логер — тож логер мусить уміти слати команди, інакше запис можливий тільки наосліп |
| 2026-08-24 | Новий CSV на кожен заголовок, а не на кожне підключення | Прошивка шле заголовок на кожен `start`, а перезавантаження плати обнуляє її мікросекундний годинник. Розбиття по заголовку тримає мітки монотонними всередині файлу — на це мовчки розраховує весь аналіз далі |
| 2026-08-24 | `OK,`/`ERR,` — окремий вид рядка, не помилка парсингу | Консоль ділить той самий UART. Класифікувати відповіді як зіпсовані дані означало б поховати справжні помилки серед них |
| 2026-08-24 | Телеметрія 460800, не 921600 | Місток — CH340 (1a86:7523), не CP2102, як припускав план. На 921600 вивід — сміття; стелю задає драйвер, а не чіп. 1645 рядків/с проти потрібних 500 |
| 2026-08-24 | `CONFIG_FREERTOS_HZ=1000` | При тіку 100 Гц `pdMS_TO_TICKS(2)` = 0 через цілочисельне ділення, і 500 Гц недосяжні в принципі. Додано `_Static_assert`, щоб факт, відомий компілятору, перевірявся компілятором |
| 2026-08-24 | Версія протоколу піднята до 2 | Поля змінили значення (S має 4 замість 3). v1-лог тепер відхиляється, а не читається неправильно — це і є призначення поля версії |
| 2026-08-24 | `current_ref_a` передається на повній частоті, не раз на секунду | §10.1 будується на різниці двох незалежних трактів. Якщо на хост їде лише один, різницю нема з чим рахувати. +6 байт на рядок: 14 КБ/с проти 46 КБ/с — місце є |
| 2026-08-24 | `rej` розбито на `sensor` / `rej_time` / `rej_val` | Три причини — три різні ремонти: проводка, годинник, не-скінченне число з калібрування. На 1 Гц байти безкоштовні, а стенд, який знає причину і мовчить, викидає власну відповідь |
| 2026-08-24 | `sample_count` доданий у підсумок | Без нього `vmin=0.000` не відрізнити від розрядженої батареї. Підтверджено на живій платі: `simulate off` дає `n=0, sensor=500` |
| 2026-08-11 | Усі вимірювання 2026-08-11 анульовані | Мультиметр DT-830 виявився несправним: свіжа AA показала 1.85 V замість 1.5–1.6. Множники завищення різні на різних вимірюваннях (1.16 / 1.27 / 1.33) — не стала розкалібровка, а плаваюча опорна напруга, тобто сідаюча крона. Резистори при цьому читались **заниженими**, а напруга — **завищеною**: різні режими збиваються по-різному, і за одним показом це неможливо було помітити |
| | | |

---

# Що треба вміти писати з нуля

Пріоритети навчання. Не все в репозиторії однаково цінне.

| Рівень | Файли | Що це означає |
|---|---|---|
| **Писати з нуля** | `.c`, `.h` | Особливо `.h` — проєктування інтерфейсу важить більше за реалізацію. Що в заголовку, що в `.c`, навіщо include guard, чому `static` не виноситься |
| **Писати з нуля** | `platform.h` як ідея | Шар абстракції: чому ядро не знає про ESP-IDF і як той самий код поїде на STM32 |
| **Читати й правити, просту версію — з нуля** | `Makefile` | Ціль, залежність, правило. Чим `.o` відрізняється від бінарника. Що робить компілятор, а що лінкер |
| **Читати й правити** | `CMakeLists.txt` | Що таке компонент IDF і як збірка знаходить твої файли. Знадобиться на Дні 3, коли core треба буде підключити до прошивки |
| **Просто користуватись** | `sdkconfig.defaults`, `.clangd`, `.vscode/*`, `compile_flags.txt`, `.gitignore` | Нуль цінності для співбесіди. Знати тільки, що `sdkconfig` генерується, а комітиться `sdkconfig.defaults` |

**Вправа на потім:** видалити `Makefile` і написати заново з пам'яті. Година роботи, після якої питання «як збирається ваш проєкт» перестає бути незручним.

Але питають зазвичай не про систему збірки, а про те, звідки береться бінарник і що в ньому — див. список нижче.

# Питання, на які маю вміти відповісти

Накопичується з денних блоків. Перед співбесідою — прогнати весь список.

- [ ] Що відбувається між подачею живлення і `app_main()`?
- [ ] Чим `.text`, `.data`, `.bss` відрізняються і де кожна лежить?
- [ ] `int x = 5;` на файловому рівні — де зберігається п'ятірка до старту і хто її копіює в RAM?
- [ ] Що робить лінкер і чому виникає `undefined reference`?
- [ ] Чому в embedded уникають `malloc`?
- [ ] Чому вказівник на незмінюваний рядок має бути `const char *`?
- [ ] Навіщо `volatile` і що конкретно ламається без нього при `-O2`?
- [ ] Чому `volatile` не робить доступ атомарним? Приклад із 64-бітною міткою часу
- [ ] Два значення слова `static` — у чому різниця?
- [ ] Як `const` на таблиці економить RAM на мікроконтролері?
- [ ] Чим `snprintf` безпечніший за `sprintf`?
- [ ] Як протестувати код, що залежить від часу?
- [ ] Чому `now - last > timeout` безпечніше за `now > last + timeout`?
- [ ] Чому сума 10 000 однакових `float` ≠ `значення × 10000`?
- [ ] Чим машина станів краща за набір прапорців?
- [ ] Як парсер відновлюється після втраченого байта?
- [ ] Чому `readline()` не гарантує цілий рядок?
- [ ] Чому `max()` — погана метрика для пікового струму?
- [ ] Що піде не так, якщо дві таски пишуть у один `float`?
- [ ] Чому команда «крутити мотор» має протухати?
- [ ] Чому дільник на 1 MΩ зіпсує вимірювання ADC?
- [ ] ADC 12 біт — це 12 біт точності?
- [ ] Чому одноразове калібрування нуля не рятує ratiometric-сенсор?
- [ ] Навіщо шунт підключають чотирма провідниками?
- [ ] Чому виміряний струм менший за розрахунковий?
- [ ] Прилад показує 1.234 A — скільки цифр мають сенс?
