misha-z1nchuk/dronebench-ate/(commit log)

2026-08-05 Bootstrap DroneBench ATE: project scaffolding and ESP32 bring-up
    Automated test equipment for 1S FPV drones — measures the power path while
    driving the flight controller through a standardised test sequence, then
    classifies the airframe and names the next diagnostic step.
    This commit covers Day 1 of the plan:
    - Host build and a minimal unit test framework that runs with no board
    attached, so the portable core stays portable by construction
    - Core layout: shared types, the platform interface every target implements,
    and the CLI contract expressed as a documented header
    - ESP32 application printing firmware version, chip model, core count,
    silicon revision, features and reset reason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
    [main.c, test_cli.c, test_framework.c, test_framework.h, test_main.c]
2026-08-06 Implement the CLI parser and consolidate the wiring design
    Day 2. The command interface is how the bench is operated: a human types
    into the serial monitor during calibration, and in phase 3 the Python runner
    sends the same commands over the same port. One interface, two users — which
    is why errors are machine-readable rather than prose.
    Parser:
    - fixed 128-byte line buffer, no dynamic allocation anywhere
    - in-place tokenising: separators are overwritten with NUL and argv points
    into the line, so nothing is copied
    - command table lookup instead of an if/else chain
    - handles CR, LF, CRLF, backspace, DEL and non-printable input
    - reports over-long lines, unknown commands and excess argum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
    [test_cli.c]
2026-08-06 Wire the CLI to the console UART
    The parser now runs on the board. Typing into the serial monitor reaches the
    same code the host tests exercise, over a transport the tests never touch.
    - cli_uart.c installs the UART0 driver and runs the reader task. It is the
    adapter between the portable parser and this particular chip; the test
    suite's output sink is the same kind of thing, which is why the parser
    needs no knowledge of either.
    - the command table lives in the application, not the core: help, version
    and status, each replying in the key=value shape the Python runner will
    parse in phase 3.
    - the core is compiled straight into the ESP-IDF component rather than
    wrapped as one, so f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
2026-08-07 Make the platform boundary real on both sides
    Day 3. platform.h existed but nothing implemented or called it — the line was
    drawn and nobody crossed it. Now both sides exist and the core reaches
    hardware only through them.
    Host side:
    - controlled clock. An hour of battery drain is expressible as one call, so
    the mAh integration tests can exist at all, and no test depends on wall
    time and fails on a busy machine for no reason.
    - injected sensor readings, per channel, each able to report unavailable.
    That makes the whole measurement pipeline testable before a single resistor
    is soldered, including the paths where a sensor drops out mid-session.
    - captured UART output, observable LE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
    [cli_uart.c, main.c, platform_esp32.c, platform_esp32.h, test_main.c]
2026-08-21 Validate samples before anything downstream trusts them
    Day 4. The sampler is the one place that decides whether a reading is
    believable. Everything after it — mAh integration, sag detection, motor
    comparison, the verdict — assumes its input is sound, so a bad sample
    admitted here becomes a wrong number in a report indistinguishable from a
    right one.
    Four outcomes rather than success/failure, each with its own counter: sensor
    failure, non-monotonic clock, non-finite value, and accepted-but-after-a-gap.
    How many samples a session failed to take is part of its result; a report
    built from three quarters of the data it should have had is obliged to say so.
    Decisions worth keeping in mind w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
    [sampler.c, test_main.c, test_sampler.c, tests.h]
2026-08-21 Accumulate session metrics without losing 1.5% to rounding
    Day 5. Charge, energy, extremes and duration, folded in one sample at a time.
    The one decision worth explaining is the width of the accumulators. An hour
    at 500 Hz is 1.8 million additions, and doing them in float loses about 1.5%
    of the total on perfectly clean input:
    correct 1000.00 mAh
    double 1000.00 mAh
    float 1014.99 mAh +1.4994%
    float precision is relative. By the time the running sum reaches 3.6e9, the
    gap between representable neighbours is 429 and the value being added is
    2000 — four of those steps. Every addition rounds, the roundings lean the
    same way, and the error grows with the sample count i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
    [metrics.c, test_main.c, test_metrics.c, tests.h]
2026-08-21 Separate where the session is from what it found
    Day 6. The plan listed IDLE, PRECHECK, RUNNING, WARNING, FAILED, COMPLETE as
    one list of states, but those are two independent axes: position in the test
    sequence, and observations made along the way. A drone can be mid-sequence
    with a warning already recorded, or fail its precheck before the sequence
    begins.
    Modelled flat, that is fifteen transitions, with WARNING duplicating almost
    every transition RUNNING has. Worse, the path RUNNING -> WARNING -> COMPLETE
    ends in COMPLETE and the warning is gone — the state does not remember having
    passed through it, so a separate flag would be needed anyway. Flat is not the
    simpler option, it is the sa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
    [test_main.c, test_session.c, tests.h]
2026-08-24 Define a telemetry format that survives a bad link
    Day 7, core half. Two line types at different rates, because they answer
    different questions.
    At 500 Hz the sample line is sent 1.8 million times an hour, so it carries
    raw readings positionally and nothing else — 22 bytes against the 80 the
    original key=value shape would have cost. The field names live in the header
    instead, sent once.
    Power and consumed charge are derived, and sending them at sample rate would
    be redundant. But the firmware sees every sample and the host sees only what
    survived the wire: if anything is dropped, the host's integral is quietly low
    while the firmware's is right. So they go out once a second, from the side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
2026-08-24 Raise the console to 460800 and stop truncating the banner
    Two things the hardware disagreed with.
    The console baud is set through sdkconfig.defaults, but ESP_CONSOLE_UART_BAUDRATE
    only carries a Kconfig prompt when the console is CUSTOM. Without that, the
    value is silently ignored and the build keeps 115200 with no warning at all.
    ESPTOOLPY_MONITOR_BAUD needs no setting: it has no prompt and defaults to the
    console rate, so `idf.py monitor` follows on its own — one place to change,
    and no way for the two to drift apart.
    460800 rather than the planned 921600. The bridge on this board turned out to
    be a CH340 (1a86:7523), not the CP2102 the plan assumed, and 921600 came
    through the macOS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
    [main.c, platform_esp32.c]
2026-08-24 Add the simulated profiles, and let the platform serve them
    Not a stand-in for the missing ADC, though it also does that job today. This
    is how a fault gets reproduced without breaking hardware: a bench that
    classifies a dead motor correctly has to be shown a dead motor, and the
    alternative is destroying one per test run. Plan section 8 lists these as
    product commands, and days 19 and 20 test the diagnostic rules against them —
    where the right answer is known because it was chosen here.
    Five profiles: normal, motor4_fail, motor2_high, sag, short. Each scripts a
    settle period, four motor slots and a tail.
    Three things the model gets right on purpose:
    - motor4_fail is an absence, not an e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
    [main.c, platform_esp32.c, platform_esp32.h, simulator.c, test_main.c, test_simulator.c, tests.h]
2026-08-24 Put the measurement loop on the wire, and revise the protocol to v2
    Day 7 finished: a 500 Hz task joins sampler, metrics and telemetry, and the
    board now streams a session over UART at 460800 with start and stop driven
    from the console.
    Numbers checked against an analytical model rather than by eye. With the
    normal profile the board reports imax=1.980 (IDLE_A + MOTOR_A), vmin=4.081
    (4.20 - 1.98 x 0.060), and mah=0.621 at n=1000. That last one only matches to
    four figures if the integral is taken over 999 intervals, not 1000 — so the
    data confirms the "first sample contributes no charge" rule as well as the
    integration itself. At 1000 it would read 0.6222, and 0.2% is easy to blame on
    roun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
2026-08-24 Log the telemetry stream to disk, and verify it against the model
    Day 8, mostly. The host reads the same wire format the firmware writes and
    refuses the same lines, because a reader more forgiving than the writer undoes
    the firmware's refusal to emit anything it could not complete: it would accept
    and record exactly the corruption that was avoided upstream.
    Three things worth stating outright.
    Bytes, not readline(). readline() with a timeout returns whatever arrived when
    the timeout expired, and the caller cannot tell that from a line that genuinely
    ended. A 28-byte sample line routinely arrives as two reads at 500 Hz, so a
    line is only released once its newline has been seen.
    flush() mov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
    [logger.py, protocol.py, test_protocol.py]
2026-08-24 Close day 8: the cable was actually pulled
    The reconnect path was written but never made to happen, which is not the same
    as working. It has now been made to happen, fifteen seconds into a recording.
    What the capture shows:
    - stream_001 holds all 7349 samples up to the moment of the yank, 14.696 s
    - errors.log is empty. The truncated line at the instant the port died was
    never emitted, because the assembler holds a line until its newline arrives.
    That is the whole reason it exists rather than readline().
    - the logger retried once a second while no device node existed, and on
    reconnect re-sent simulate and start on its own — that block sits inside the
    reconnect loop, so driving th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
2026-08-24 Turn a recording into a report that says what to do next
    Day 9. Graphs, section 11 report, and the rules from section 10 — with the
    thresholds in test_profiles/meteor75pro.toml rather than in the code, because
    a limit nobody measured must be visible as such.
    There are four verdicts and INCONCLUSIVE outranks PASS. A run that could not
    be judged is not a run that passed, and treating it as one is how a bench ends
    up certifying a drone it never measured. It is returned when a threshold still
    reads "tbd", when the firmware accepted no samples — every figure then reads
    0.000 because nothing was measured rather than because nothing was there — and
    when only one current channel answered, sin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
    [stream_001_samples.csv, stream_001_summaries.csv]
2026-08-24 Split the pipeline into tasks, and prove the watchdog actually fires
    Day 10, except the ten-minute soak. Four tasks and two queues, not the three
    the plan called for — the CLI task has existed since day 2 and was never
    counted.
    The boundary is not "what does this task do" but "what does it sleep on". A
    task can wait on exactly one thing, which is why one task cannot both read
    commands from the UART and drain an output queue, and why the split falls
    where it does: measure sleeps on its own timer and may never block, output
    sleeps on the output queue, process on the sample queue, cli on UART RX.
    The two answers to "the queue below is full" differ on purpose, because the
    losses differ. Meas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
2026-08-24 Close day 10: ten minutes at 500 Hz with nothing lost
    300028 samples over 600.054 s, 600 summaries, no parse errors, and every loss
    counter at zero — sensor, time, value, gaps, drops.
    The interval figure is the one worth keeping. All 300027 gaps between samples
    were exactly 2000 us; not one deviation in ten minutes. A 14.7 s run before the
    split showed +/-2 us on 8% of intervals, so the most likely cause of the
    improvement is the split itself: the timed path now holds only sampler_take
    and xQueueSend, while the metrics and the snprintf moved to a task that is
    allowed to take as long as it likes. Short, constant-time work under a timer
    behaves better than short-on-average work.
    That also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
